bidic/armd-msc-thesis/DarkExplorerMScThesis/source/hardware.tex

\newpage
\part{Rozwój platformy robota mobilnego}
\section{Lokalizcja twarzy na obrazie}
\subsection{Algorytmy}
\subsection{Implementacja}
\section{Czujniki podczerwieni}
\subsection{Omijanie przeszkód}
