bidic/armd-msc-thesis/DarkExplorerMScThesis/source/ch03_development/s02_gyroscope.tex

\section{Żyroskop}
\label{sec:gyro}
Do budowy inercjalnej jednostki pomiarowej został użyty żyroskop trójosiowy
wykonany w technologii MEMS. Żyroskopy wyprodukowane w tej technologii są
wykorzystywane np.: w stabilizatorach obrazu do kamer lub kontrolerach do gier
wideo. Ich główną zaletą jest mały rozmiar. W poniższym podrozdziale zostanie 
przedstawiona zasada działania takiego żyroskopu oraz sposób wykorzystania go w
robocie mobilnym.

\subsection{Zasada działania}
% http://www.electroiq.com/index/display/nanotech-article-display/4659348781/articles/small-times/nanotechmems/mems/sensors/2010/11/introduction-to-mems-gyroscopes.htm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

% http://elektronikab2b.pl/technika/12098-yroskopy-i-akcelerometry-mems-w-elektronice-uytkowej
% wykorzystać rysunki z powyższej strony
Żyroskopy MEMS korzystają z pozornej siły Coriolis'a (rys. \ref{fig:Coriolis}) do
pomiaru prędkości kątowej z jaką obraca się ciało. 

\begin{figure}[!ht]
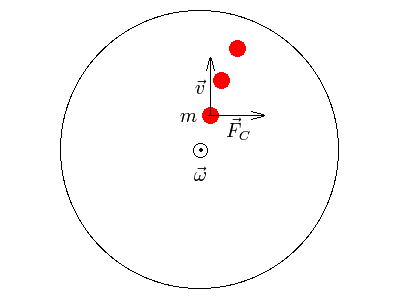
[picture p17: DarkExplorerMScThesis/images/ch04/coriolis.png]
 \centering 
 \caption{Siła Coriolis'a}
 \label{fig:Coriolis}
\end{figure}

Załóżmy, że ciało o masie $m$ porusza się z prędkością $\vec{v}$ oraz układ w
którym przemieszcza się to ciało obraca się z prędkością kątową $\vec{\omega}$. W
takich warunkach ciało o~którym mowa zostanie odchylone od kierunku
przemieszczania się wyznaczonego przez wektor prędkości $\vec{v}$. Odchylenie to
będzie spowodowane siłą Coriolis'a $\vec{F_{c}}$ którą można opisać przy pomocy
wzoru \ref{eq:coriolis}. Żyroskopy MEMS wykorzystują to zjawisko określając
przemieszczenie drgającego ciała, które jest tak naprawdę jedną z okładek
kondensatora, jako zmianę pojemności.
\begin{equation}
  \label{eq:coriolis}
  \vec{F_{c}} = -2m \left(\vec{\omega}\times\vec{v}\right)
\end{equation}
\newpage
Żyroskopy tego typu posiadają dwa oscylujące miniaturowe elementy które poruszają się w przeciwnych względem siebie kierunkach (rys. \ref{fig:ZyroOsc}). 
\begin{figure}[!ht]
 \centering
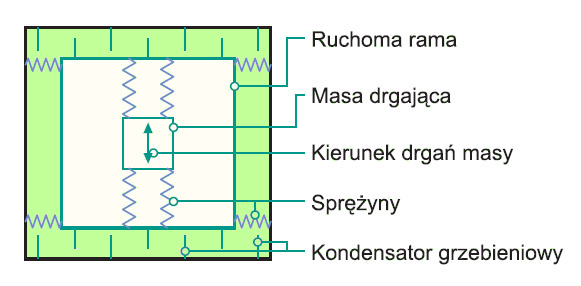
[picture p18: DarkExplorerMScThesis/images/ch04/mems_osc.jpg]
 
 \caption{Budowa elementu pomiarowego żyroskopu\cite{website::elektronikab2b.pl}}
 \label{fig:ZyroOsc}
\end{figure}

Jeżeli urządzenie do którego przymocowany jest żyroskop zacznie się obracać,
spowoduje to wychylenie się oscylujących elementów w przeciwnych kierunkach
(rys. \ref{fig:ZyroCoriolis}). Wychylenie to z kolei powoduje zmianę pojemności, a
różnica pomiędzy pojemnościami zmierzonymi przy pomocy obydwu ruchomych
elementów jest proporcjonalna do prędkości kątowej. W ten sposób zmierzona
szybkość obrotu jest następnie reprezentowana jako wynik analogowy (napięcie)
lub cyfrowy (wartość liczbowa). \begin{figure}[!ht]
 \centering
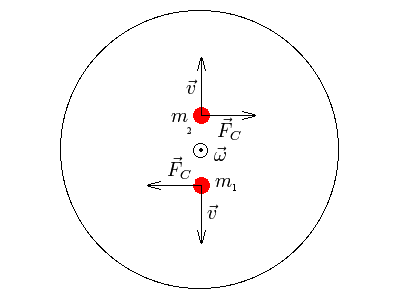
[picture p19: DarkExplorerMScThesis/images/ch04/gyro-coriolis.png]
 
 \caption{Dwie oscylujące masy odchylane przez siłę Coriolis'a}
 \label{fig:ZyroCoriolis}
\end{figure}

Wynik działania żyroskopu MEMS jest obojętny na zmianę przyspieszenia liniowego,
w szczególności na przyspieszenie ziemskie. Przyspieszenie liniowe wywoła
wychylenie się jednocześnie obydwu elementów oscylujących w tym samym kierunku. W~ten sposób nie~będzie wykryta żadna różnica pojemności. Prędkość kątowa
wskazywana przez żyroskop nie ulegnie zmianie. Dzięki temu żyroskopy MEMS są
odporne na wstrząsy, uderzenia oraz wibracje.

Podstawowe wielkości charakteryzujące żyroskop:
% \begin{itemize}
%  \item zakres $[dps\footnote{dps - stopień na sekundę}]$ -- definiuje wartość maksymalną i minimalną jaką żyroskop jest w stanie
%  zmierzyć. Często żyroskop ma kilka zakresów z których możemy wybrać jeden odpowiadający naszym potrzebom.
%  \item czułość $[\frac{mdps}{digit}]$ -- wielkość określająca wartość minimalną jaką żyroskop może zmierzyć
%  \item zmiana czułości względem temperatury $[\%]$ -- określa jak bardzo pomiary urządzenia są podatne na zmianę temperatury
%  \item zakres poziomu zero $[dps]$ -- określa zakres w jakim pomiary mogą się wahać w chwili gdy żyroskop pozostaje w spoczynku
%  \item zmiana zakresu poziomu zero względem temperatury $[\frac{dps}{^{\circ}C}]$ -- definiuje zmiany pomiarów żyroskopu pozostającego w spoczynku względem temperatury
%  \item nieliniowość $[\% FS]$ -- parametr określa maksymalne procentowe odchylenie wartości na wyjściu żyroskopu od dopasowanej do nich linii prostej
%  \item przepustowość $[Hz]$ -- definiuje częstotliwość z jaką są wykonywane pomiary
% \end{itemize}

\begin{basedescript}{\desclabelstyle{\pushlabel}\desclabelwidth{45mm}}
\setlength{\parsep}{2pt}
\setlength{\itemsep}{6mm}
\setlength{\parskip}{2pt}
\item[Zakres {$[dps\footnote{dps - stopień na sekundę}]$}]
	Definiuje wartość maksymalną i minimalną prędkości kątowej jaką żyroskop
	jest w stanie zmierzyć. Często żyroskop ma kilka zakresów z których możemy wybrać jeden odpowiadający naszym potrzebom.
\item[Czułość {$[\frac{mdps}{digit}]$}] 
	Wielkość określająca wartość minimalną prędkości kątowej jaką żyroskop może
	zmierzyć.
\item[Zmiana czułości względem temperatury {$[\%]$}] \hfill \\
	Określa jak bardzo pomiary urządzenia są podatne na zmianę temperatury.
\item[Zkres poziomu zero {$[dps]$}] \hfill \\
	Definiuje zakres w jakim pomiary mogą się wahać w chwili gdy~żyroskop pozostaje
	w spoczynku.
\item[Zmiana zakresu poziomu zero względem temperatury
{$[\frac{dps}{^{\circ}C}]$}] \hfill \\
	Określa zmiany pomiarów żyroskopu pozostającego w spoczynku względem
	temperatury.
\item[Nieliniowość {$[\% FS]$}] 
	Parametr określa maksymalne procentowe odchylenie wartości na wyjściu żyroskopu
	od dopasowanej do nich linii prostej.
\item[Przepustowość {$[Hz]$}] 
	Definiuje częstotliwość z jaką żyroskop może wykonywać kolejne pomiary.
\end{basedescript}

\subsection{Kalibracja i odczytywanie wyników}
Żyroskopy są zazwyczaj fabrycznie testowane i kalibrowane pod kątem zakresów pomiarów poziomu zerowego oraz czułości. 
Jednak po umieszczeniu elementu na płytce PCB\footnote{PCB (z ang. Printed
Circuit Board) - płyta obwodu drukowanego} zostaje on poddany naprężeniom przez
co może być potrzebna dodatkowa kalibracja układu. Wartości wyjściowe
otrzymywane w wyniku pomiaru przeprowadzonego za~pomocą żyroskopu można
przedstawić za~pomocą równania \ref{eq:gyro-output}:

\begin{equation}
	\label{eq:gyro-output}
  \omega_{t} = \omega_{m} - \omega_{0}
\end{equation}
\begin{tabbing}
  gdzie: \= \\
    \> $\omega_{t}$ -- rzeczywista wartość prędkości kątowej, \\
    \> $\omega_{m}$ -- pomiar z żyroskopu,\\
    \> $\omega_{0}$ -- wartość zerowa reprezentująca brak ruchu,\\
\end{tabbing}

W celu kompensacji niestabilności żyroskopu należy pozostawić urządzenie
nieruchome i wykonać około tysiąc pomiarów. Następnie konieczne jest obliczenie
wartości średniej z wykonanych pomiarów. W ten sposób określimy średnie wychylenie od wartości zerowej żyroskopu, czyli nasze $\omega_{0}$.

Podczas używania żyroskopu do pomiaru bardzo małych prędkości kątowych należy
jeszcze wziąć pod uwagę minimalne odchylenia wartości w zależności od zmiany temperatury.
Prędkość kątową opisujemy wzorem \ref{eq:predkosckatowa}: 
\begin{equation}
  \label{eq:predkosckatowa}
  \omega = \frac{d\varphi}{dt}
\end{equation}

Wzór na kąt o jaki zostało obrócone ciało poruszające się z prędkością kątową
$\omega$ (równanie \ref{eq:katcalkowanie}) wyprowadzamy całkując obustronnie
równanie \ref{eq:predkosckatowa}.
\begin{equation}
  \label{eq:katcalkowanie}
  \varphi = \int \omega dt
\end{equation}

Do obliczenia kąta obrotu można wykorzystać jedną z numerycznych metod
całkowania, np. metodę trapezów (rys. \ref{fig:CalkowanieTrapezy}). Metoda ta
polega na podzieleniu pola pod wykresem całkowanej funkcji na wąskie trapezy, a następnie zsumowanie pól tych
trapezów.

\begin{figure}[!ht]
 \centering
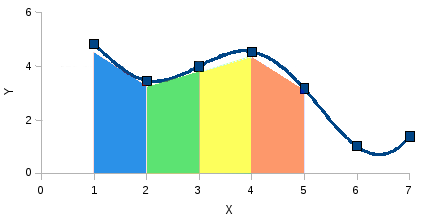
[picture p20: DarkExplorerMScThesis/images/ch04/calkowanie-metoda-trapezow.png]
 
 \caption[Całkowanie przy pomocy metody trapezów]{Całkowanie przy pomocy metody trapezów\footnotemark}
 \label{fig:CalkowanieTrapezy}
\end{figure}

Po wykorzystaniu metody trapezów, wzór na kąt o jaki żyroskop został obrócony
w~czasie pomiędzy dwoma pomiarami, można zapisać w postaci równania \ref{eq:angle-gyro}:

\footnotetext{źródło: http://mateusz-lach.blogspot.com/2010/09/cakowanie-numeryczne.html}
\begin{equation}
 \label{eq:angle-gyro}
  \varphi = C_{f} \cdot \frac{\omega_{i-1} + \omega_{i}}{2} \cdot \Delta t
\end{equation}
\begin{tabbing}
  gdzie: \= \\
    \> $C_{f}$ -- współczynnik korygujący, \\
    \> $\Delta t$ -- czas jaki upłynął pomiędzy dwoma pomiarami,\\
    \> $\omega_{i-1}$ -- szybkość kątowa odczytana z poprzedniego pomiaru,\\
    \> $\omega_{i}$ -- szybkość kątowa odczytana z obecnego pomiaru,\\
\end{tabbing}

W taki sposób otrzymujemy wzór \ref{eq:total-gyro-angle}, na kąt o jaki ciało
zostało obrócone w czasie $\Delta t$. Kąt całkowity pomiędzy orientacją początkowa a orientacją
końcową ciała jest sumą wszystkich wykonanych pomiarów kątów.
\begin{equation}
  \label{eq:total-gyro-angle}
  \varphi_{c} = \varphi_{0} + \sum_{i=1}^{n} \varphi_{i} 
\end{equation}
\begin{tabbing}
  gdzie: \= \\
    \> $\varphi_{0}$ -- kąt początkowy,\\
    \> $\varphi_{i}$ -- wartość kąta z pojedynczego pomiaru\\
\end{tabbing}
Do otrzymania jak najlepszych wyników konieczne jest określenie współczynnika korygującego pomiar żyroskopu.
W tym celu porównujemy wyniki pomiarów żyroskopu z~pomiarami innych przyrządów np. magnetometru wykorzystując wzór:
\begin{equation}
  C_{f} = \frac{\varphi_{o}}{\varphi_{g}}
\end{equation}
\begin{tabbing}
  gdzie: \= \\
    \> $C_{f}$ -- współczynnik korygujący, \\
    \> $\varphi_{o}$ -- kąt obliczony przy pomocy urządzenia zewnętrznego,\\
    \> $\varphi_{g}$ -- kąt wyznaczony przez żyroskop,\\
\end{tabbing}

Niestety z powodu ciągle nakładających się błędów całkowania oraz niedoskonałości
samego żyroskopu, wskazywany kąt odchylenia od ułożenia początkowego będzie się
oddalał od wartości rzeczywistej wraz z upływem czasu. W przypadku tej pracy
dyplomowej nie jest jednak potrzebna bardzo wysoka stabilność i precyzja wartości
mierzonych przez żyroskop dla długich okresów pomiarowych.

 \begin{figure}[h!]
 \centering
 \subfloat[Zmiany wartości rejestrów podczas obrotu]{\label{fig:gyro-angle-vel}
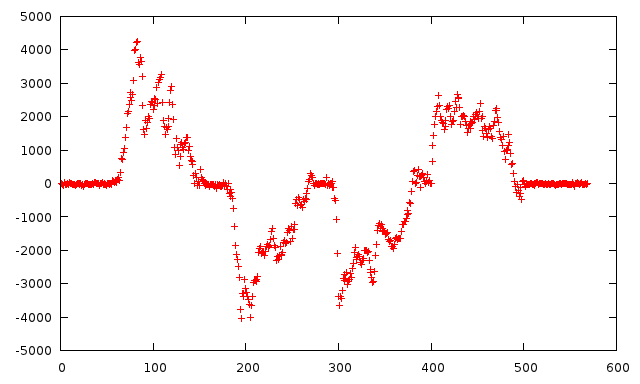
[picture p21: DarkExplorerMScThesis/images/ch04/gyro-angle-velocity.png]
 	}
 %\hfill \\
 \subfloat[Zmiany kąta wychylenia z pozycji startowej]{\label{fig:gyro-angle}
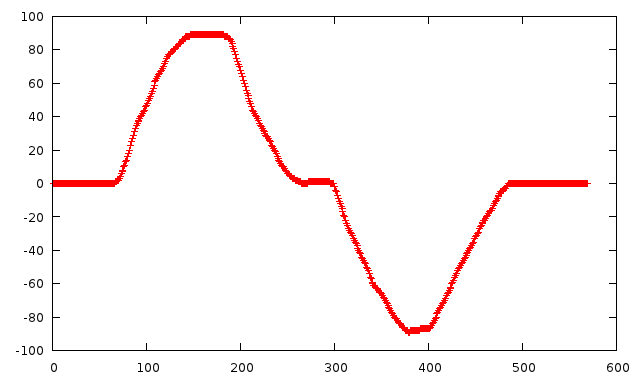
[picture p22: DarkExplorerMScThesis/images/ch04/gyro-angle.png]
 	}
 \caption{Dane o obrocie zarejestrowane za pomocą modułu żyroskopu}
 \label{fig:gyro-angle-plot}
\end{figure}

Rysunek \ref{fig:gyro-angle-plot} przedstawiają informacje o obrocie robota uzyskane za pomocą
żyroskopu. Robot został najpierw obrócony o $90^{\circ}$ w lewo po czym
przekręcono go do położenia pierwotnego, następnie obrócono go o $90^{\circ}$ w prawo i
ponownie przywrócono jego pierwotne ustawienie. Na rysunku \ref{fig:gyro-angle-vel} zostały
przedstawione kolejne wartości rejestrów żyroskopu odzwierciedlających prędkość
kątową z jaką poruszał się czujnik wokół osi~Z~podczas wykonywania pomiarów.
Wykres przedstawiony na rysunku \ref{fig:gyro-angle}, pokazuje efekt działania
algorytmu odpowiedzialnego za całkowanie pomiarów z żyroskopu i przeliczanie ich~na~wartość
kąta. Na osi Y wykresu widzimy wartość kąta obrotu, natomiast oś~X~określa
numer kolejnego pomiaru.

\subsection{Opis zastosowanego elementu i budowy modułu}
W robocie został użyty ultra-stabilny trójosiowy żyroskop cyfrowy L3G4200D firmy
STMicroelectronics. Jego główną zaletą jest bardzo dobra jakość pomiarów
osiągnięta dzięki zastosowaniu innowacyjnej struktury mechanicznej. Zazwyczaj
urządzenia tego typu stosują dwie lub trzy struktury odpowiedzialne za
wykonywanie pomiarów. Żyroskop firmy STMicroelectronics natomiast posiada jeden
taki element odpowiedzialny za pomiar na wszystkich osiach. Takie rozwiązanie
eliminuje zakłócenia pomiędzy osiami, powodowane przez same elementy pomiarowe.

Zgodnie z notą katalogową\cite{L3G4200DDataSheet} dostępną na stronie
internetowej producenta żyroskop L3G4200D zamontowany w robocie posiada
charakterystykę mechaniczną taką jak zaprezentowano w tabeli
\ref{tab:L3G4200DMechChar}:

\begin{table}[hb]
\rowcolors{2}{white}{gray!20}
\centering
\caption{Charakterystyka mechaniczna żyroskopu L3G4200D dla napięcia zasilania
$3.0 V$ i temperatury pracy $25^{\circ}C$}
 \begin{tabular}{ | c | c | c | c | c | p{1.75cm} |} \hline
   		Symbol & Parametr & Warunki testowe & Wartość & Jednostka \\ \hline
   		& & & $\pm 250$ & \\
   		FS & Skala & & $\pm 500$ & dps\\
   		& & & $\pm 2000$ & \\ \hline
   		& & $FS = 250 dps$  & $8.75$  & \\
   		So  & Czułość & $FS = 500 dps$ & $17.50$  & $\frac{mdps}{digit}$ \\
   		& & $FS = 2000 dps$  & $70$  & \\ \hline
   		SoDr & Zmiana czułości & $-40^{\circ}C$ do $+85^{\circ}C$ & $\pm 2$  & \% \\
		& względem temperatury & & &  \\ \hline
		& & $FS = 250 dps$ & $\pm 10$  &  \\
   		DVoff & Zakres poziomu zero & $FS = 500 dps$  & $\pm 15$ & dps \\
   		& & $FS = 2000 dps$ & $\pm 75$ & \\ \hline
   		OffDr & Zmiana zakresu poziomu & $FS = 250 dps$  & $\pm 0.03$ & dps \\
   		& zero względem temperatury & $FS = 2000 dps$ & $\pm 0.04$ & \\ \hline
		NL & Nieliniowość & & $\pm 0.2$ & \% FS \\ \hline
		Rn & Współczynnik szumów & $BW = 50 Hz$ & $\pm 0.03$ & $\frac{dps}{\sqrt{Hz}}$ \\ \hline
		ODR & Częstotliwość odświeżania & & $100/200$ & $Hz$ \\
		& danych na wyjściu & & $400/800$ & \\ \hline
		Top & Zakres temperatur & & od $-40^{\circ} C$& $^{\circ} C$ \\
		& operacyjnych & & do $+85^{\circ} C$ & \\ \hline
   	\end{tabular}
\label{tab:L3G4200DMechChar}
\end{table}
\newpage
Aby możliwe stało się podłączenie żyroskopu do robota, została zaprojektowana w~programie Eagle specjalna płytka podłączeniowa widoczna na rysunku \ref{fig:L3G4200DPCB}.
\begin{figure}[!ht]
 \centering
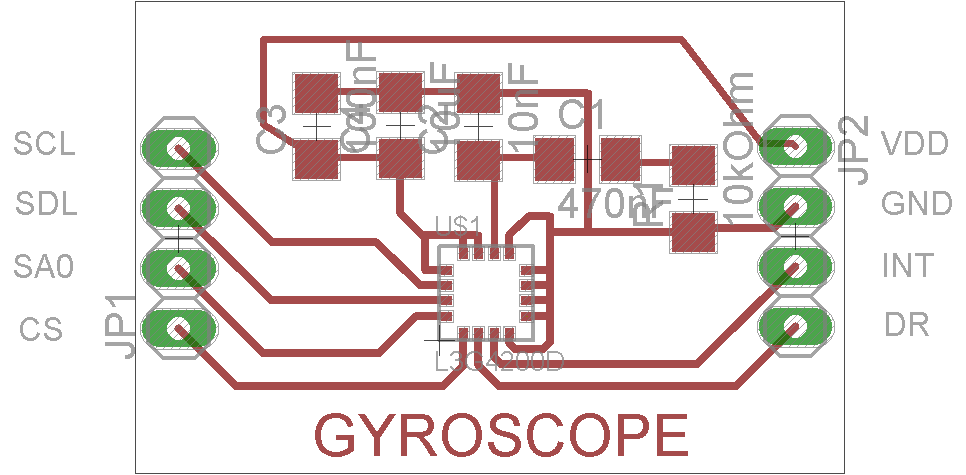
[picture p23: DarkExplorerMScThesis/images/ch04/L3G4200Dpcb.png]
 
 \caption{Płytka PCB modułu żyroskopu trójosiowego}
 \label{fig:L3G4200DPCB}
\end{figure}

Schemat układu umożliwiającego podłączenie czujnika został przedstawiony na
rysunku \ref{fig:L3G4200DSchem}. Jego projekt został stworzony na podstawie
wspomnianej wcześniej noty katalogowej. \begin{figure}[!ht]
 \centering
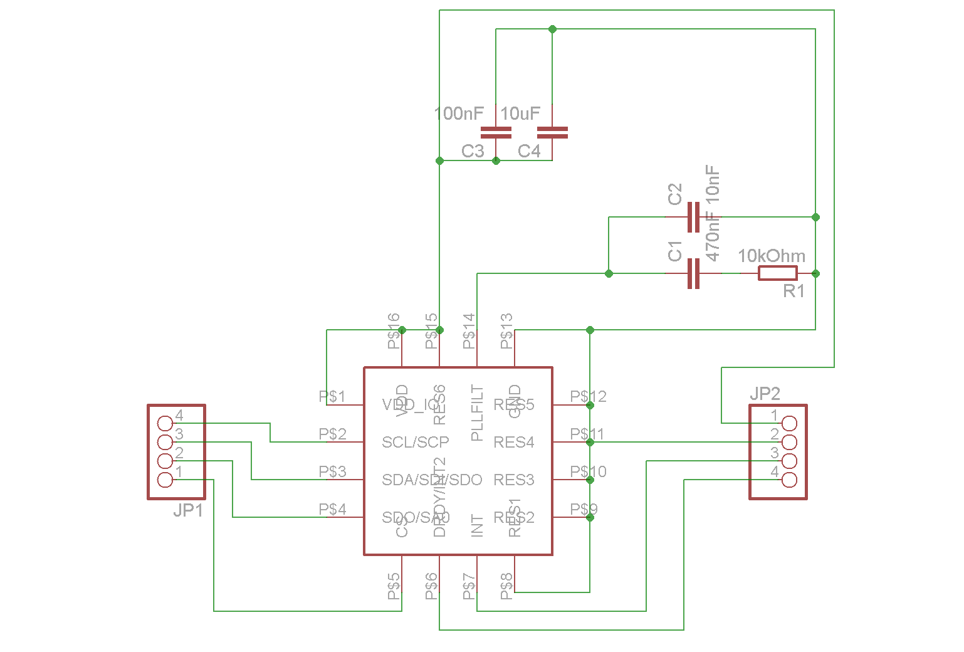
[picture p24: DarkExplorerMScThesis/images/ch04/L3G4200Dschematic.png]
 
 \caption{Schemat płytki PCB modułu żyroskopu}
 \label{fig:L3G4200DSchem}
\end{figure}

Płytka modułu została zaprojektowana z wykorzystaniem elementów
SMD\footnote{SMD -- Surface Mount Device} w obudowie 1206. Rozmiar obudowy tych
elementów został wymuszony przez brak kondensatorów ceramicznych o pojemności $10\mu F$ w obudowie mniejszej. Cały proces tworzenia
płytki modułu żyroskopu był przeprowadzony metodami domowymi ze względu na niski
koszt oraz brak konieczności czekania kilku tygodni na wykonanie takiej płytki
przez specjalistyczną firmę. Szczegółowy opis procesu tworzenia płytki metodami
domowymi można znaleźć w~dodatku \ref{chap:pcb}. Poniżej zamieszczone zostało
zdjęcie \ref{fig:L3G4200DModule} przedstawiające gotowy moduł żyroskopu oraz
tabela \ref{tab:L3G4200DModOut} omawiająca szczegółowo wyprowadzenia modułu
umożliwiające jego podłączenie do robota.
\begin{figure}[!ht]
 \centering
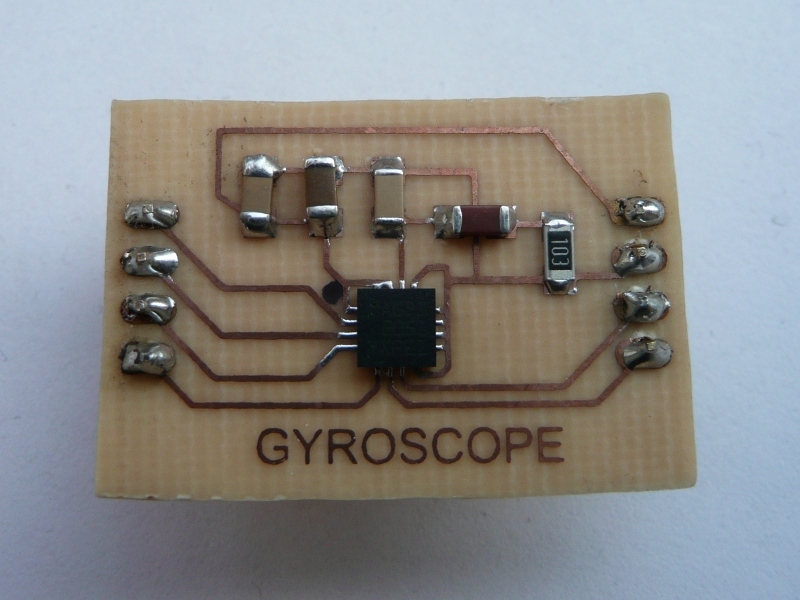
[picture p25: DarkExplorerMScThesis/images/ch04/gyromodule.jpg]
 
 \caption{Gotowy moduł żyroskopu}
 \label{fig:L3G4200DModule}
\end{figure} 
\begin{table}[hb]
  \rowcolors{2}{white}{gray!20}
  \centering
  \caption{Opis wyprowadzeń płytki modułowej żyroskopu}
  \begin{tabular}{ | c | c | c | p{1.75cm} |} \hline
    Nazwa & Typ & Opis \\ \hline
    VDD & Zasilanie & Napięcie zasilania $3.3V$ \\
    GND & Zasilanie & Masa \\
    INT & Wyjście & Konfigurowalny pin przerywania \\
    DR  & Wyjście & Pin informujący o nowych danych do pobrania \\
    SCL & Wejście & Zegar sterujący $I^{2}C$ \\
    SDL & We / Wy & Szyna do przesyłania danych $I^{2}C$ \\
    SA0 & Wejście & Najmniej znaczący bit adresu urządzenia \\
    CS  & Wejście & Przełącznik trybu działania $I^{2}C$ lub SPI \\ \hline
  \end{tabular}
  \label{tab:L3G4200DModOut}
\end{table}
