bidic/armd-msc-thesis/DarkExplorerMScThesis/source/appendix/source_code.tex

\label{ch:source-code}
W tym załączniku zamieszczony został kod źródłowy części oprogramowania,
które zostało stworzone w trakcie realizacji pracy magisterskiej. Wszystkie
zamieszczone w tym rozdziale fragmenty kodu, mają charakter poglądowy i służyć
mogą jedynie jako podstawowa dokumentacja, pozwalająca zrozumieć architekturę
zaimplementowanych rozwiązań. Rozdział ten należy traktować jako
uzupełnienie informacji przedstawionych w~ramach poprzednich rozdziałów.
Czytelnik zainteresowany dostępem do pełnego kodu źródłowego wraz z dokumentacją
programisty, może takowy znaleźć na dołączonym do pracy nośniku CD. Wspomnianą
dokumentację wraz z najaktualniejszą wersją źródeł można również pobrać ze
strony \url{http://lumifun.ftj.agh.edu.pl/doku.php?id=user:hanusiak_nowacki:start}.

\section{Dokumentacja kodu źródłowego robota}
\newpage
\subsection{Moduły urządzeń peryferyjnych}
\lstinputlisting[language=C,caption=Interfejs modułu obsługi GPIO
(pio\_helper.h)]{appendix/src/embeded/pio_helper.h}
\lstinputlisting[language=C,caption=Interfejs modułu obsługi bluetooth
(usart\_helper.h)]{appendix/src/embeded/usart_helper.h}\newpage
\lstinputlisting[language=C,caption=Interfejs modułu obsługi ADC
(adc\_helper.h)]{appendix/src/embeded/adc_helper.h}
\lstinputlisting[language=C,caption=Interfejs modułu obsługi PWM
(pwm\_helper.h)]{appendix/src/embeded/pwm_helper.h}
\subsection{Moduły płyty rozszerzeń}
\lstinputlisting[language=C,caption=Interfejs modułu obsługi kamery
(po6030k.h)]{appendix/src/embeded/po6030k.h}
\lstinputlisting[language=C,caption=Interfejs modułu dalmierza
(sharp\_gp2d12.h)]{appendix/src/embeded/sharp_gp2d12.h}
\lstinputlisting[language=C,caption=Interfejs modułu magnetometru
(mmc212xm.h)]{appendix/src/embeded/mmc212xm.h}
\lstinputlisting[language=C,caption=Interfejs modułu żyroskopu
(l3g4200d.h)]{appendix/src/embeded/l3g4200d.h}
\lstinputlisting[language=C,caption=Interfejs modułu obsługi wyświetlacza LCD
(hy1602f6.h)]{appendix/src/embeded/hy1602f6.h}
\lstinputlisting[language=C,caption=Interfejs modułu akcelerometru
(freescale\_mma7260.h)]{appendix/src/embeded/freescale_mma7260.h}
\lstinputlisting[language=C,caption=Interfejs modułu obsługi multipleksera
(cd4053b.h)]{appendix/src/embeded/cd4053b.h}
\lstinputlisting[language=C,caption=Interfejs modułu pamięci flash
(at45db321d.h)]{appendix/src/embeded/at45db321d.h}

\newpage
\subsection{Moduły algorytmów systemu wbudowanego}
\lstinputlisting[language=C,caption=Interfejs modułu omijania przeszkód
(obstacle\_avoidance.h)]{appendix/src/embeded/obstacle_avoidance.h}
\lstinputlisting[language=C,caption=Interfejs modułu liczenia kroków
(pedometer.h)]{appendix/src/embeded/pedometer.h}
\lstinputlisting[language=C,caption=Interfejs modułu rekonstrukcji ścieżki
(reverse\_track\_reconstruction.h)]{appendix/src/embeded/reverse_track_reconstruction.h}
\section{Dokumentacja biblioteki dla języka Java}
\lstinputlisting[language=Java,caption=Źródła klasy sterującej
(Controller.java)]{appendix/src/java/Controller.java} 
\lstinputlisting[language=Java,caption=Źródła klas obsługi połączenia bluetooth
(BTConnection.java)]{appendix/src/java/BTConnection.java}
\section{Dokumentacja biblioteki dla języka C\#}
\lstinputlisting[language=CSharp,caption=Źródła klasy sterującej
(DarkExplorer.cs)]{appendix/src/csharp/DarkExplorer.cs} 
\lstinputlisting[language=CSharp,caption=Źródła klas obsługi protokołu
komunikacji (DarkExplorerComm.cs)]{appendix/src/csharp/DarkExplorerComm.cs}
\lstinputlisting[language=CSharp,caption=Źródła klas typów pomocniczych
(DarkExplorerTypes.cs)]{appendix/src/csharp/DarkExplorerTypes.cs}
\lstinputlisting[language=CSharp,caption=Źródła klas zdarzeń
(DarkExplorerEvents.cs)]{appendix/src/csharp/DarkExplorerEvents.cs}
