bidic/armd-msc-thesis/DarkExplorer_by_Kmak/plytki_drukowane/plyta_glowna.png

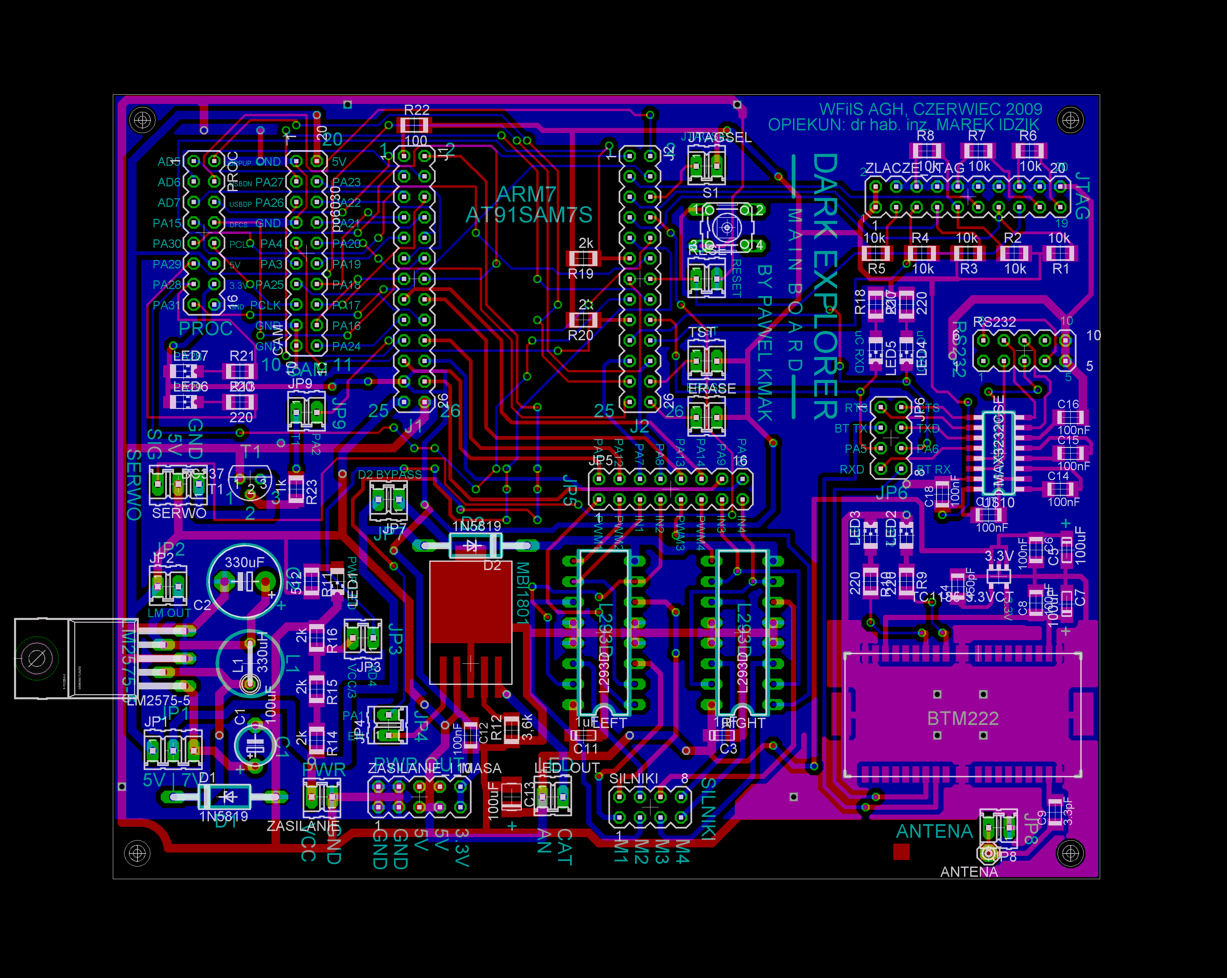
DarkExplorer_by_Kmak/plytki_drukowane/plyta_glowna.png
