bidic/armd-msc-thesis/DarkExplorer_by_Kmak/plytki_drukowane/plyta_glowna_sch.png

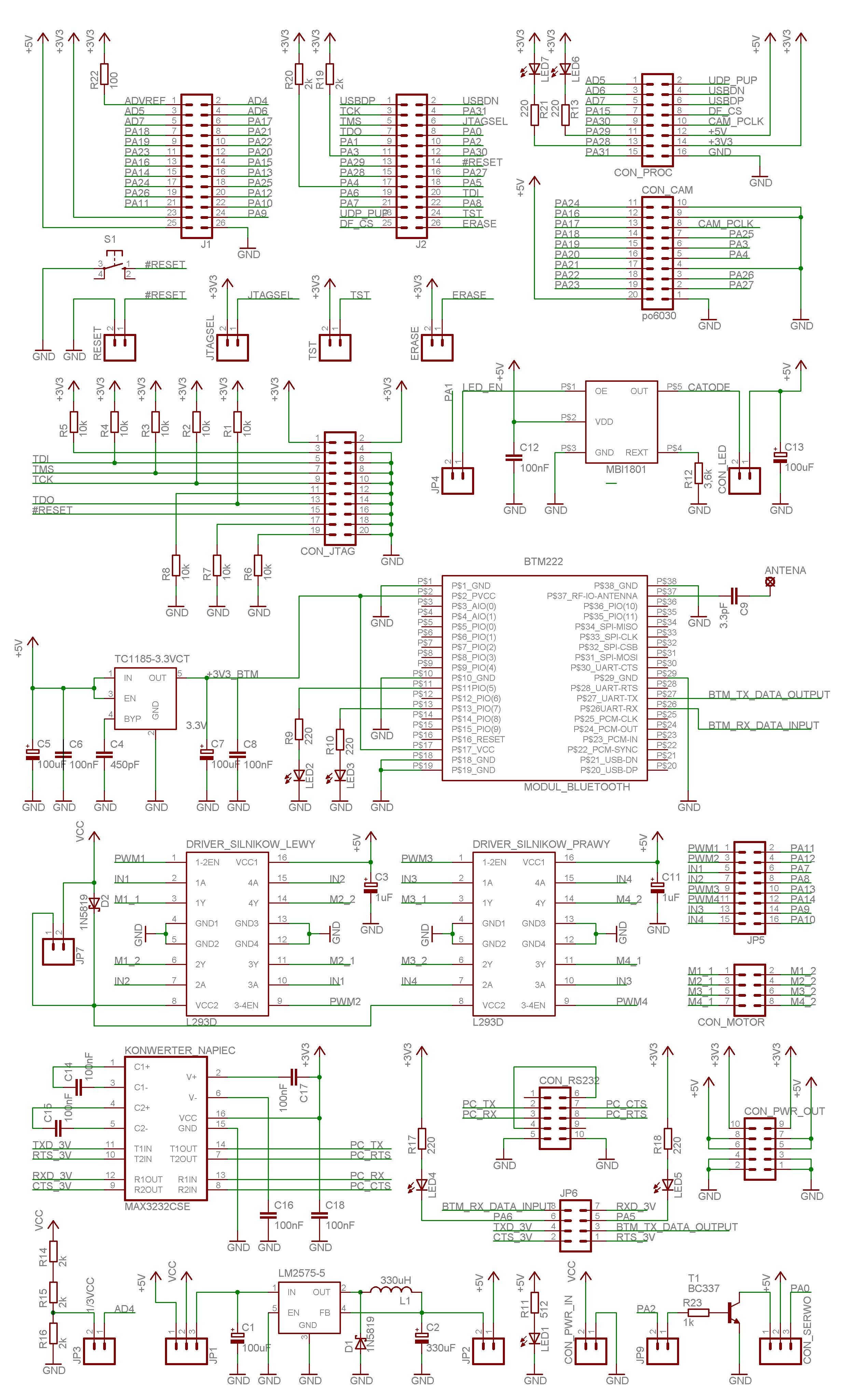
DarkExplorer_by_Kmak/plytki_drukowane/plyta_glowna_sch.png
