bidic/armd-msc-thesis/DarkExplorer_by_Kmak/plytki_drukowane/plytka_kamery.png

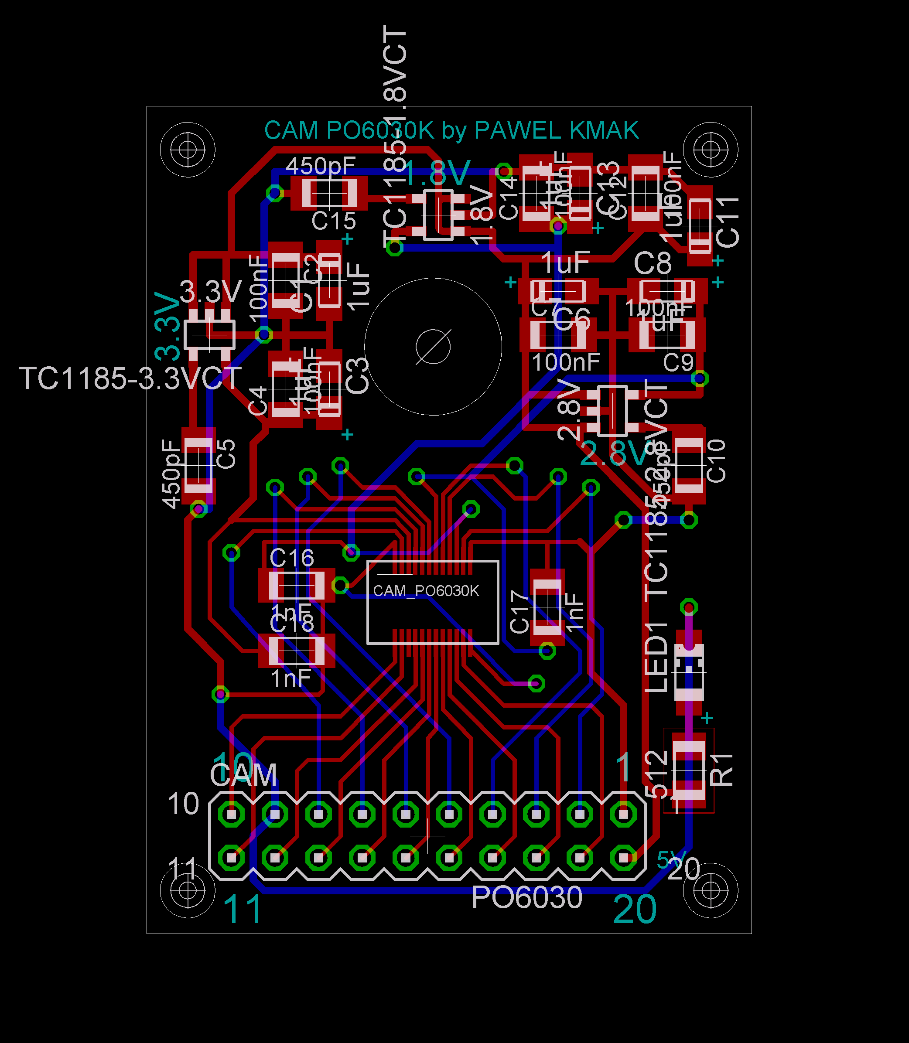
DarkExplorer_by_Kmak/plytki_drukowane/plytka_kamery.png
