bidic/armd-msc-thesis/DarkExplorer_by_Kmak/plytki_drukowane/plytka_kamery_sch.png

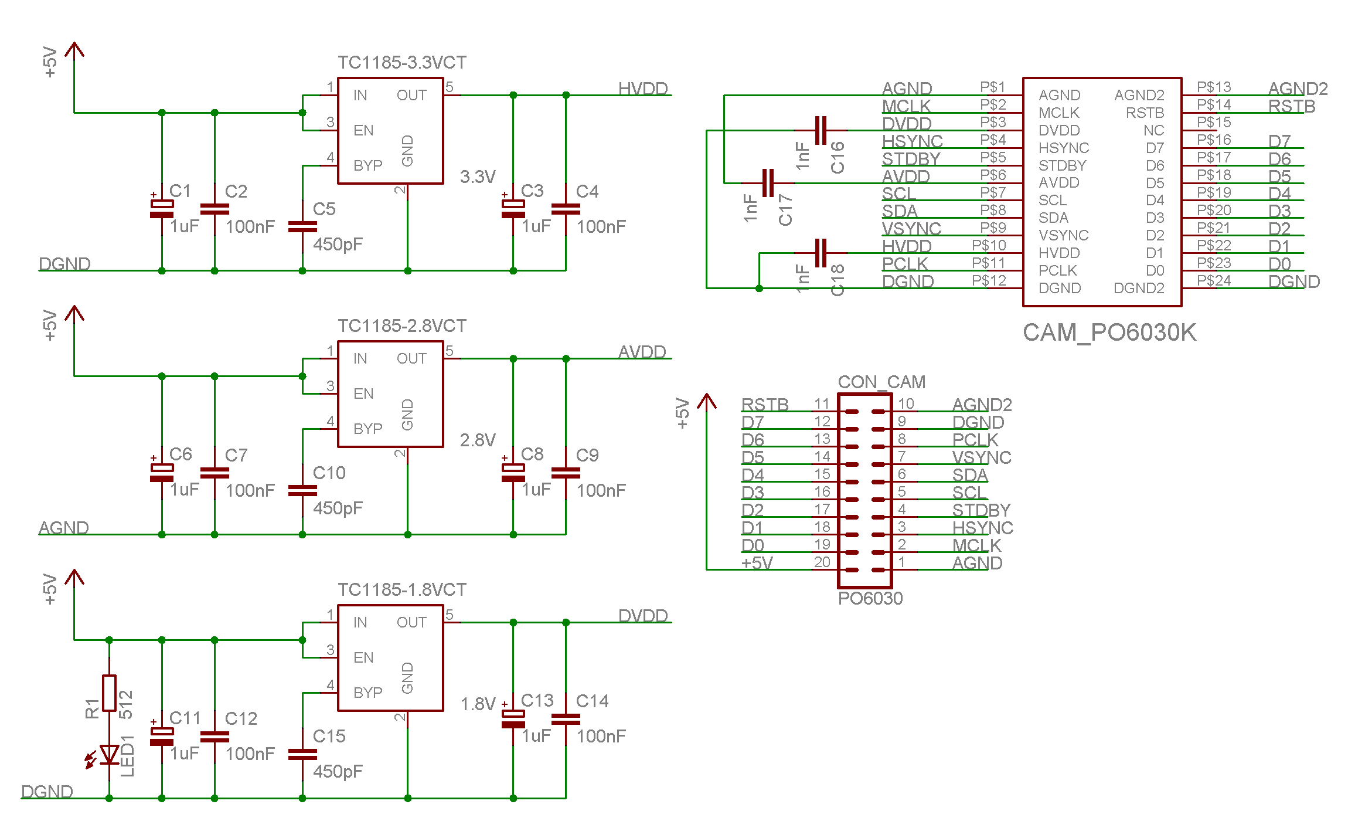
DarkExplorer_by_Kmak/plytki_drukowane/plytka_kamery_sch.png
