bidic/armd-msc-thesis/DarkExplorerMScThesis/images/ch03/wm-config-3.png

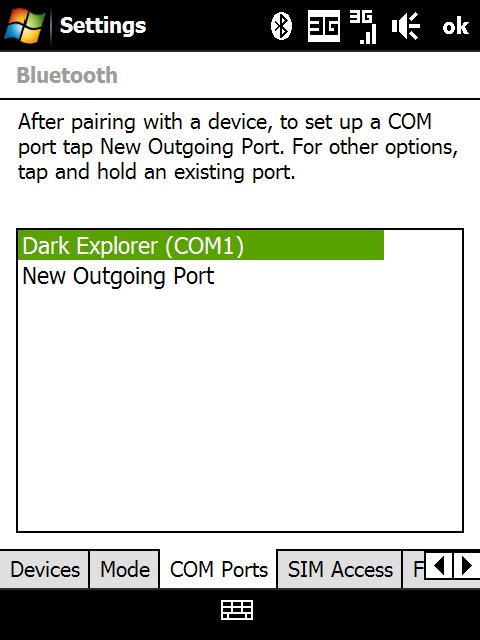
DarkExplorerMScThesis/images/ch03/wm-config-3.png
