bidic/armd-msc-thesis/DarkExplorerMScThesis/images/ch04/gp2d12.png

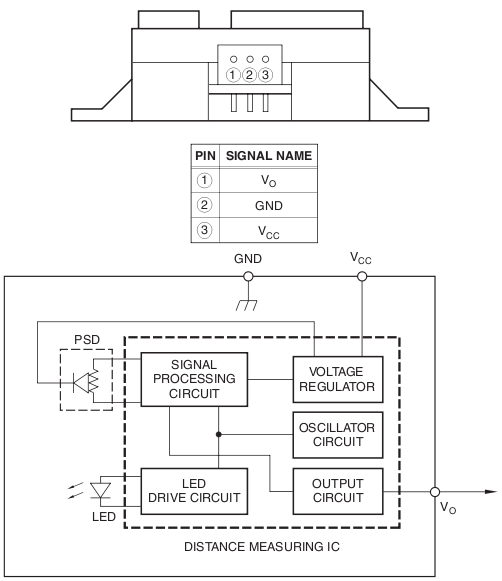
DarkExplorerMScThesis/images/ch04/gp2d12.png
