bidic/armd-msc-thesis/DarkExplorerMScThesis/images/ch04/gp2d12_view.png

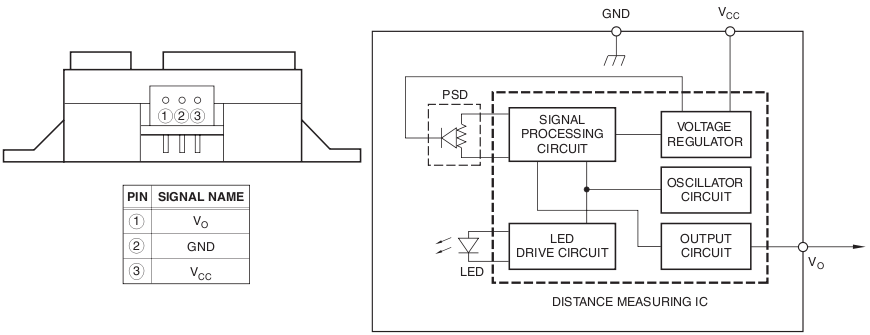
DarkExplorerMScThesis/images/ch04/gp2d12_view.png
