bidic/armd-msc-thesis/DarkExplorerMScThesis/images/ch05/bt_conn_stages.png

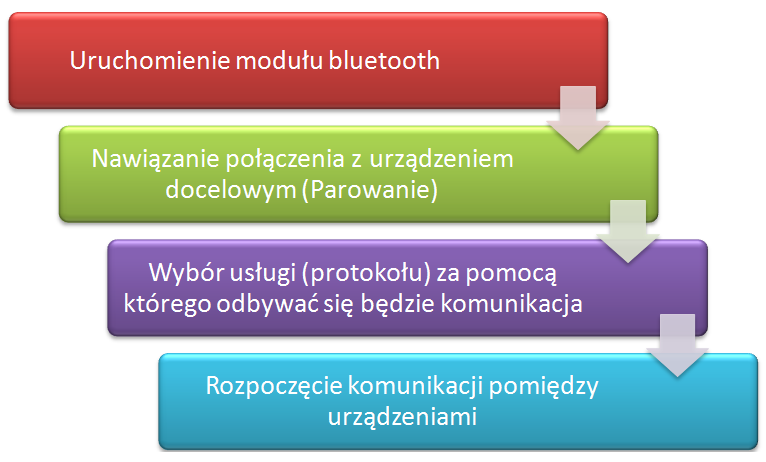
DarkExplorerMScThesis/images/ch05/bt_conn_stages.png
