bidic/armd-msc-thesis/DarkExplorerMScThesis/images/ch05/req_schema.png

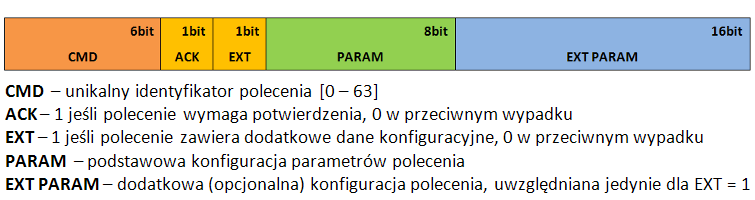
DarkExplorerMScThesis/images/ch05/req_schema.png
