bidic/armd-msc-thesis/DarkExplorerMScThesis/images/ch05/resp_schema.png

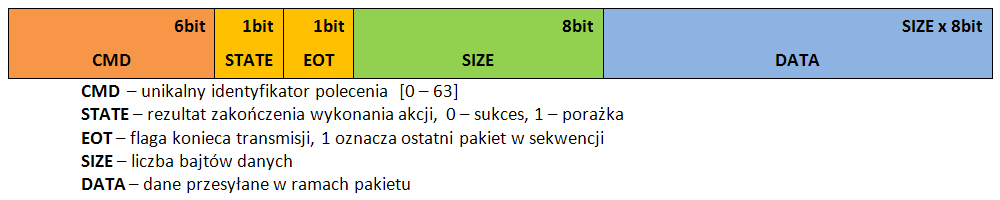
DarkExplorerMScThesis/images/ch05/resp_schema.png
