bidic/armd-msc-thesis/DarkExplorerMScThesis/images/ch03/jtag-install-s1.png

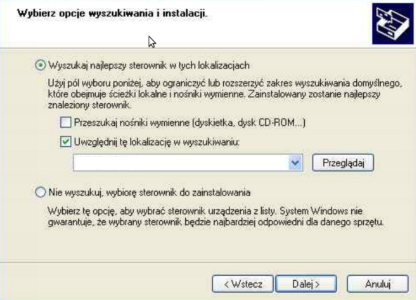
DarkExplorerMScThesis/images/ch03/jtag-install-s1.png
