bidic/armd-msc-thesis/DEFirmware-2010/firmware/peripherals.c

/**
 * Projekt    : Dark Explorer firmware
 * Plik       : perupherals.c
 * Zawartosc  : Funkcje do obs�ugi urz�dze� peryferyjnych procesora
 * Autor      : Pawe� Kmak
 * Data       : 1.08.2009
 **/

#include <de_board.h>
#include <de_pio.h>
#include <aic/aic.h>
#include <pmc/pmc.h>
#include <pwmc/pwmc.h>
#include <usart/usart.h>

////////////////////////////////////////////////////////////////////////////////

////////////////////////////////////////////////////////////////////////////////
__ramfunc void SYSTEM_INTERRUPT_irq_handler(void);
__ramfunc void UART0_DMA_irq_handler(void);

////////////////////////////////////////////////////////////////////////////////
// Opoznienie ok 1ms przy MCK=48MHz
////////////////////////////////////////////////////////////////////////////////
void waitms(volatile unsigned long d) {
	// dla MCK 48MHz
	d = 2000 * d;
	for (; d; --d)
		;
}

////////////////////////////////////////////////////////////////////////////////
// Konfiguracja timera PIT (serwo)
////////////////////////////////////////////////////////////////////////////////
void PIT_Configure(int czas_us) {
	unsigned int dummy, piv;
	float tmp;


	AT91C_BASE_PITC->PITC_PIMR = ~(AT91C_PITC_PITEN | AT91C_PITC_PITIEN);

	//oczekiwanie na wyzerowanie licznika (pole CPIV w rejestrze PIVR)
	while (AT91C_BASE_PITC->PITC_PIVR & AT91C_PITC_CPIV)
		;


	dummy = AT91C_BASE_PITC->PITC_PIVR;

	//konfiguracja przerwania
	AIC_ConfigureIT(AT91C_ID_SYS, AT91C_AIC_PRIOR_LOWEST
			| AT91C_AIC_SRCTYPE_HIGH_LEVEL, SYSTEM_INTERRUPT_irq_handler);
	//  AT91F_AIC_ConfigureIt ( AT91C_BASE_AIC, AT91C_ID_SYS, AT91C_AIC_PRIOR_LOWEST, AT91C_AIC_SRCTYPE_HIGH_LEVEL, SYSTEM_INTERRUPT_irq_handler);
	AIC_EnableIT(AT91C_ID_SYS);
	//  AT91F_AIC_EnableIt (AT91C_BASE_AIC, AT91C_ID_SYS);


	//piv = (   ( czas_us * ( (MCK/16)/1000 ) ) / 1000   );
	tmp = ((((float) MCK) / (16000000.0)) * (float) czas_us) - 1.0;
	piv = tmp;
	AT91C_BASE_PITC->PITC_PIMR = (piv | AT91C_PITC_PITEN | AT91C_PITC_PITIEN);
}

////////////////////////////////////////////////////////////////////////////////

////////////////////////////////////////////////////////////////////////////////
void PIT_ChangeInterval(int czas_us) {
	unsigned int piv;
	float tmp;
	tmp = ((((float) MCK) / (16000000.0)) * (float) czas_us) - 1.0;
	piv = tmp;
	AT91C_BASE_PITC->PITC_PIMR = (piv | AT91C_PITC_PITEN | AT91C_PITC_PITIEN);
}

////////////////////////////////////////////////////////////////////////////////

////////////////////////////////////////////////////////////////////////////////
void PWM_Configure() {

	//wlaczenie zegara dla pwm
	PMC_EnablePeripheral(AT91C_ID_PWMC);
	//  AT91F_PMC_EnablePeriphClock ( AT91C_BASE_PMC, 1 << AT91C_ID_PWMC );

	PWMC_ConfigureChannel(0, 0x6 << 0, 0x1 << 8, 0x1 << 9 | 0x0 << 10);
	//	PWMC_ConfigureChannel(1, 0x6 << 0, 0x1 << 8, 0x1 << 9 | 0x0 << 10);
	//	PWMC_ConfigureChannel(2, 0x6 << 0, 0x1 << 8, 0x1 << 9 | 0x0 << 10);
	//	PWMC_ConfigureChannel(3, 0x6 << 0, 0x1 << 8, 0x1 << 9 | 0x0 << 10);
	//  //wylaczenie wszystkich kanalow przed zmiana konfiguracji
	//  AT91C_BASE_PWMC->PWMC_DIS = (AT91C_PWMC_CHID0 | AT91C_PWMC_CHID1 | AT91C_PWMC_CHID2 | AT91C_PWMC_CHID3);
	//

	//  while(AT91C_BASE_PWMC->PWMC_SR & (AT91C_PWMC_CHID0 | AT91C_PWMC_CHID1 | AT91C_PWMC_CHID2 | AT91C_PWMC_CHID3) );
	//
	//  //KONFIGURACJA TRYBU PRACY
	//  //    - prescaler = MCK/64
	//  //    - alligment = center
	//  //    - polarity = high
	//  //    - update = duty
	//  AT91C_BASE_PWMC->PWMC_CH[0].PWMC_CMR = (0x6 << 0 | 0x1 << 8 | 0x1 << 9 | 0x0 << 10);
	//  AT91C_BASE_PWMC->PWMC_CH[1].PWMC_CMR = (0x6 << 0 | 0x1 << 8 | 0x1 << 9 | 0x0 << 10);
	//  AT91C_BASE_PWMC->PWMC_CH[2].PWMC_CMR = (0x6 << 0 | 0x1 << 8 | 0x1 << 9 | 0x0 << 10);
	//  AT91C_BASE_PWMC->PWMC_CH[3].PWMC_CMR = (0x6 << 0 | 0x1 << 8 | 0x1 << 9 | 0x0 << 10);
	//
	// rozdzielczosc = 255
	PWMC_SetPeriod(0, 255);
//	PWMC_SetPeriod(1, 255);
//	PWMC_SetPeriod(2, 255);
//	PWMC_SetPeriod(3, 255);
	//  AT91C_BASE_PWMC->PWMC_CH[0].PWMC_CPRDR = 256;
	//  AT91C_BASE_PWMC->PWMC_CH[1].PWMC_CPRDR = 256;
	//  AT91C_BASE_PWMC->PWMC_CH[2].PWMC_CPRDR = 256;
	//  AT91C_BASE_PWMC->PWMC_CH[3].PWMC_CPRDR = 256;

	// wypelnienie poczatkowe = 1
	PWMC_SetDutyCycle(0, 1);
//	PWMC_SetDutyCycle(1, 1);
//	PWMC_SetDutyCycle(2, 1);
//	PWMC_SetDutyCycle(3, 1);
	//  AT91C_BASE_PWMC->PWMC_CH[0].PWMC_CDTYR = 2;
	//  AT91C_BASE_PWMC->PWMC_CH[1].PWMC_CDTYR = 2;
	//  AT91C_BASE_PWMC->PWMC_CH[2].PWMC_CDTYR = 2;
	//  AT91C_BASE_PWMC->PWMC_CH[3].PWMC_CDTYR = 2;

	//KONFIGURACJA WYPROWADZENIA PA11, PA12, PA13, PA14
//	AT91F_PIO_CfgPeriph(AT91C_BASE_PIOA, 0, AT91C_PA11_PWM0 );


	PWMC_EnableChannel(0);
//	PWMC_EnableChannel(1);
//	PWMC_EnableChannel(2);
//	PWMC_EnableChannel(3);
	//  AT91C_BASE_PWMC->PWMC_ENA = (AT91C_PWMC_CHID0 | AT91C_PWMC_CHID1 | AT91C_PWMC_CHID2 | AT91C_PWMC_CHID3);

}

////////////////////////////////////////////////////////////////////////////////

////////////////////////////////////////////////////////////////////////////////
void PWM_Set(int channel, char duty) {
	//ustawienie wypelnienia
	// channel = 0 - 3, duty = 2 - 255
//	AT91C_BASE_PWMC->PWMC_CH[channel].PWMC_CUPDR = duty;
	PWMC_SetDutyCycle(channel, duty);
}

////////////////////////////////////////////////////////////////////////////////

////////////////////////////////////////////////////////////////////////////////
void PDC_Disable(AT91PS_PDC pPDC) {
	//wylaczenie nadajnika i odbiornika
	pPDC->PDC_PTCR = (AT91C_PDC_TXTDIS | AT91C_PDC_RXTDIS);

	//zerowanie rejestrow
	pPDC->PDC_TPR = 0; // Transmit Pointer Register
	pPDC->PDC_TCR = 0; // Transmit Counter Register
	pPDC->PDC_TNPR = 0; // Transmit Next Pointer Register
	pPDC->PDC_TNCR = 0; // Transmit Next Counter Register

	pPDC->PDC_RPR = 0; // Receive Pointer Register
	pPDC->PDC_RCR = 0; // Receive Counter Register
	pPDC->PDC_RNPR = 0; // Receive Next Pointer Register
	pPDC->PDC_RNCR = 0; // Receive Next Counter Register
}

////////////////////////////////////////////////////////////////////////////////

////////////////////////////////////////////////////////////////////////////////
void PDC_Enable(AT91PS_PDC pPDC) {
	//wlaczenie nadajnika /*i odbiornika*/
	pPDC->PDC_PTCR = (AT91C_PDC_TXTEN /*| AT91C_PDC_RXTEN*/);
}

////////////////////////////////////////////////////////////////////////////////
// Kontroler DMA - przekazanie danych do nadania
////////////////////////////////////////////////////////////////////////////////
void PDC_SetTX(char *data, int ile, AT91PS_PDC pPDC) {

	pPDC->PDC_TPR = (unsigned int) data; // Transmit Pointer Register
	pPDC->PDC_TCR = ile; // Transmit Counter Register
}

////////////////////////////////////////////////////////////////////////////////
// Kontroler DMA - przekazanie danych do odbioru
////////////////////////////////////////////////////////////////////////////////
void PDC_SetRX(char *data, int ile, AT91PS_PDC pPDC) {

	pPDC->PDC_RPR = (unsigned int) data; // Receive Pointer Register
	pPDC->PDC_RCR = ile; // Receive Counter Register
}

////////////////////////////////////////////////////////////////////////////////
// Konfiguracja USART0 w trybie DMA (DMA tylko do nadawania)

////////////////////////////////////////////////////////////////////////////////
void UART0_DMA_Configure(unsigned long baudrate) {
	float podzielnik_float;
	int calkowity, ulamkowy;
	unsigned int mode = AT91C_US_USMODE_NORMAL | /* Normal Mode */
	AT91C_US_CLKS_CLOCK | /* Clock = MCK */
	AT91C_US_CHRL_8_BITS | /* 8-bit Data  */
	AT91C_US_PAR_NONE | /* No Parity   */
	AT91C_US_NBSTOP_1_BIT; /* 1 Stop Bit  */


	PMC_EnablePeripheral(AT91C_ID_US0);
	//  AT91F_PMC_EnablePeriphClock ( AT91C_BASE_PMC, 1 << AT91C_ID_US0 );


	USART_Configure(AT91C_BASE_US0, mode, baudrate, BOARD_MCK);

	//wylaczenie przyjmowania przerwan
	AT91C_BASE_US0->US_IDR = 0xFFFFFFFF;

	USART_SetReceiverEnabled(AT91C_BASE_US0, 0);
	USART_SetTransmitterEnabled(AT91C_BASE_US0, 0);
	//  //reset portu
	//  AT91C_BASE_US0->US_CR = AT91C_US_RSTRX |          /* Reset Receiver      */
	//                          AT91C_US_RSTTX |          /* Reset Transmitter   */
	//                          AT91C_US_RXDIS |          /* Receiver Disable    */
	//                          AT91C_US_TXDIS;           /* Transmitter Disable */
	//wylaczenie DMA
	PDC_Disable(AT91C_BASE_PDC_US0);

	//  //konfiguracja USART0
	//  AT91C_BASE_US0->US_MR = AT91C_US_USMODE_NORMAL |   /* Normal Mode */
	//                          AT91C_US_CLKS_CLOCK    |    /* Clock = MCK */
	//                          AT91C_US_CHRL_8_BITS   |    /* 8-bit Data  */
	//                          AT91C_US_PAR_NONE      |    /* No Parity   */
	//                          AT91C_US_NBSTOP_1_BIT;      /* 1 Stop Bit  */
	//predkosc
	//AT91C_BASE_US0->US_BRGR = (MCK/16/baudrate);
	//wyliczenie podzielnikow zegara MCLK

	podzielnik_float = ((float) MCK / 16.0 / (float) baudrate);
	calkowity = podzielnik_float;
	podzielnik_float = (podzielnik_float - calkowity) * 8;
	ulamkowy = podzielnik_float;
	AT91C_BASE_US0->US_BRGR = (calkowity) | (ulamkowy << 16); /* podzielnik calkowity + podzielnik ulamkowy */

	//konfiguracja przerwania
	AIC_ConfigureIT(AT91C_ID_US0, 0x3 | AT91C_AIC_SRCTYPE_HIGH_LEVEL,
			UART0_DMA_irq_handler);
	//  AT91F_AIC_ConfigureIt ( AT91C_BASE_AIC, AT91C_ID_US0, 0x3, AT91C_AIC_SRCTYPE_HIGH_LEVEL, UART0_DMA_irq_handler);
	AIC_EnableIT(AT91C_ID_US0);
	//  AT91F_AIC_EnableIt (AT91C_BASE_AIC, AT91C_ID_US0);


	USART_SetReceiverEnabled(AT91C_BASE_US0, 1);
	USART_SetTransmitterEnabled(AT91C_BASE_US0, 1);
	//  AT91C_BASE_US0->US_CR = AT91C_US_RXEN  |          /* Receiver Enable     */
	//                          AT91C_US_TXEN;            /* Transmitter Enable  */

	//wlaczenie DMA (nadawanie)
	PDC_Enable(AT91C_BASE_PDC_US0);

	//konfiguracja wyprowadzen
	AT91F_PIO_CfgPeriph(AT91C_BASE_PIOA, (AT91C_PA5_RXD0 | AT91C_PA6_TXD0), 0);

	//wlaczenie przerwania od odbiornika
	AT91C_BASE_US0->US_IER = (0x1 << 0); //RXRDY
}

////////////////////////////////////////////////////////////////////////////////

////////////////////////////////////////////////////////////////////////////////
void UART0_DMA_Write(char *data, int ile) {
	//oczekiwanie na zakonczenie wysylania poprzedniego zestawu
	while (AT91C_BASE_PDC_US0->PDC_TCR)
		;

	//rozpoczecie wysylania nowego zestawu danych
	PDC_SetTX(data, ile, AT91C_BASE_PDC_US0);

	//przerwanie gdy transfer sie zakonczy
	//AT91C_BASE_US0->US_IER = (0x1 << 4);
}

////////////////////////////////////////////////////////////////////////////////
// USART0 - odbieranie danych po wystapieniu przerwania RXRDY
////////////////////////////////////////////////////////////////////////////////
char UART0_Read(void) {
	return USART_Read(AT91C_BASE_US0, 10);
	//  return (AT91C_BASE_US0->US_RHR & 0xFF);
}

////////////////////////////////////////////////////////////////////////////////

////////////////////////////////////////////////////////////////////////////////
void UART0_DMA_Read(char *data, int ile) {
	//oczekiwanie na zakonczenie odbierania poprzedniego zestawu
	while (AT91C_BASE_PDC_US0->PDC_RCR)
		;

	//rozpoczecie odbierania nowego zestawu danych
	PDC_SetRX(data, ile, AT91C_BASE_PDC_US0);

	//przerwanie gdy transfer sie zakonczy
	AT91C_BASE_US0->US_IER = (0x1 << 3);
}
