bidic/armd-msc-thesis/DarkExplorerMScThesis/source/appendix/src/embeded/sharp_gp2d12.h

#ifndef SHARP_GP2D12_H_
#define SHARP_GP2D12_H_

/*
 * Na podstawie podanego napiecia i charakterystki
 * podanej w dokumentacji wylicza odleglosc od przeszkody
 *
 * \param output Wartosc napiecia odczytana z dalmierza
 */
unsigned int GP2D12_ComputeDistanceFromCharacterisic(unsigned int output);

#endif /* SHARP_GP2D12_H_ */
