bidic/armd-msc-thesis/DEFirmware-2010/firmware/modules/sharp_gp2d12.h

#ifndef SHARP_GP2D12_H_
#define SHARP_GP2D12_H_

#include <math.h>

/*
 * Na podstawie napięcia podanego i charakterystki znanej z dokumentacji wylicza odległość od przeszkody
 */
unsigned int GP2D12_ComputeDistanceFromCharacterisic(unsigned int output);

#endif /* SHARP_GP2D12_H_ */
