bidic/armd-msc-thesis/DEFirmware-2010/firmware/rozpoznawanie.h

/*
 * rozpoznawanie.h
 *
 *  Created on: 2010-06-21
 *      Author: m_nowy
 */

#ifndef ROZPOZNAWANIE_H_
#define ROZPOZNAWANIE_H_

////////////////////////////////////////////////////////////////////////////////
// Analiza i rozpoznawanie
////////////////////////////////////////////////////////////////////////////////
int Rozpoznaj();


#endif /* ROZPOZNAWANIE_H_ */
