bidic/armd-msc-thesis/(commit log)

2010-03-01 Dark explorer by Kmak
    [baterie.brd, plyta_glowna.brd, plyta_glowna.sch, po6030k_plytka.brd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]
2010-06-08 JTAG drivers; OpenOCD scripts for XP
    [at91sam7_FLASH.cfg, at91sam7_RAM.cfg, at91sam7sx.cfg]
2011-01-06 aktualizacja obsługi ADC dla biblioteki AT91SAM7S256
2011-02-18 Dodana obsluga sensora pola magnetycznego
2011-03-13 Poprawki w zyroskopie + poczatek magnetometru
2011-03-17 Dodane projekty modułów z Eagle'a
    [L3G4200D.brd, L3G4200D.sch, mmc2120mg.brd, mmc2120mg.sch]
2011-05-02 poprawki końcowe: stage 1
